MusIF-MIAI/ge-120-test-rig/card-tester/testplates.h

struct ge_testplates {
    const char *code;
    const char *name;
    const size_t count;
    const uint32_t cases[];
};

struct ge_testplates plate_0610001E = {
    "0610001E", "ANDO 2A", 5, {
        0x001fa004, /* 000000000111111010000000000100 */
        0x3fbfb804, /* 111111101111111011100000000100 */
        0x3fa01ff8, /* 111111101000000001111111111000 */
        0x001fa7fc, /* 000000000111111010011111111100 */
        0x00001000, /* 000000000000000001000000000000 */
    },
};

struct ge_testplates plate_0610003N = {
    "0610003N", "CAIN 2A", 17, {
        0x0c380201, /* 001100001110000000001000000001 */
        0x0501c2be, /* 000101000000011100001010111110 */
        0x0121a01c, /* 000001001000011010000000011100 */
        0x0515e8dd, /* 000101000101011110100011011101 */
        0x0d0108f0, /* 001101000000010000100011110000 */
        0x0f086b65, /* 001111000010000110101101100101 */
        0x061c2d45, /* 000110000111000010110101000101 */
        0x072d8dd7, /* 000111001011011000110111010111 */
        0x0324055f, /* 000011001001000000010101011111 */
        0x0e340d41, /* 001110001101000000110101000001 */
        0x04254e12, /* 000100001001010100111000010010 */
        0x06244e4a, /* 000110001001000100111001001010 */
        0x0730c859, /* 000111001100001100100001011001 */
        0x0c300853, /* 001100001100000000100001010011 */
        0x0d20ccdb, /* 001101001000001100110011011011 */
        0x0d20c85b, /* 001101001000001100100001011011 */
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
        0x30eab020, /* 110000111010101011000000100000 */
        0x3082f5e0, /* 110000100000101111010111100000 */
        0x3211d107, /* 110010000100011101000100000111 */
        0x20b0d507, /* 100000101100001101010100000111 */
        0x3414c110, /* 110100000101001100000100010000 */
    },
};

struct ge_testplates * tests[] = {
    &plate_0610001E,
    &plate_0610003N,
    &plate_0610004B,
    &plate_0610005F,
    &plate_0610006K,
    &plate_0610007P,
    &plate_0610008C,
    &plate_0610009G,
    &plate_0610010S,
    &plate_0610011T,
    &plate_0610012F,
    &plate_0610013B,
    &plate_0610014Y,
    &plate_0610015U,
    &plate_0610016G,
    &plate_0610017C,
    &plate_0610018Z,
    &plate_0610019V,
    &plate_0610020T,
    &plate_0610021U,
    &plate_0610022G,
    &plate_0610023C,
    &plate_0610028S,
    &plate_0610032H,
    &plate_0610034S,
    &plate_0610035W,
    &plate_0610036A,
    &plate_0610037E,
    &plate_0610038T,
    &plate_0610039X,
    &plate_0610040V,
    &plate_0610041W,
    &plate_0610042A,
    &plate_0610043E,
    &plate_0610044T,
    &plate_0610045X,
    &plate_0610046B,
    &plate_0610047F,
    &plate_0610048U,
    &plate_0610049Y,
    &plate_0610050W,
    &plate_0610052B,
    &plate_0610055Y,
    &plate_0610056C,
    &plate_0610058V,
    &plate_0610060X,
    &plate_0610061Y,
    &plate_0610062C,
    &plate_0610064V,
    &plate_0610065Z,
    &plate_0610066D,
    &plate_0610067H,
    &plate_0610068W,
    &plate_0610069S,
    &plate_0610071Z,
    &plate_0610072D,
    &plate_0610073H,
    &plate_0610074W,
    &plate_0610075S,
    &plate_0610076E,
};
