MusIF-MIAI/ge-120-test-rig/(commit log)

2022-09-11 Add draft images for the cpu and an example PCB
2023-07-29 adding missing test plates
2023-07-29 add arduino sketch
2023-07-30 add more plates
2023-07-30 converting plates to c
2023-07-30 plate fixes
2023-07-31 cleanup arduino sketch
